mgvillafane/Calhacks-13.0-Smart-Helmet/esp32-connections.png

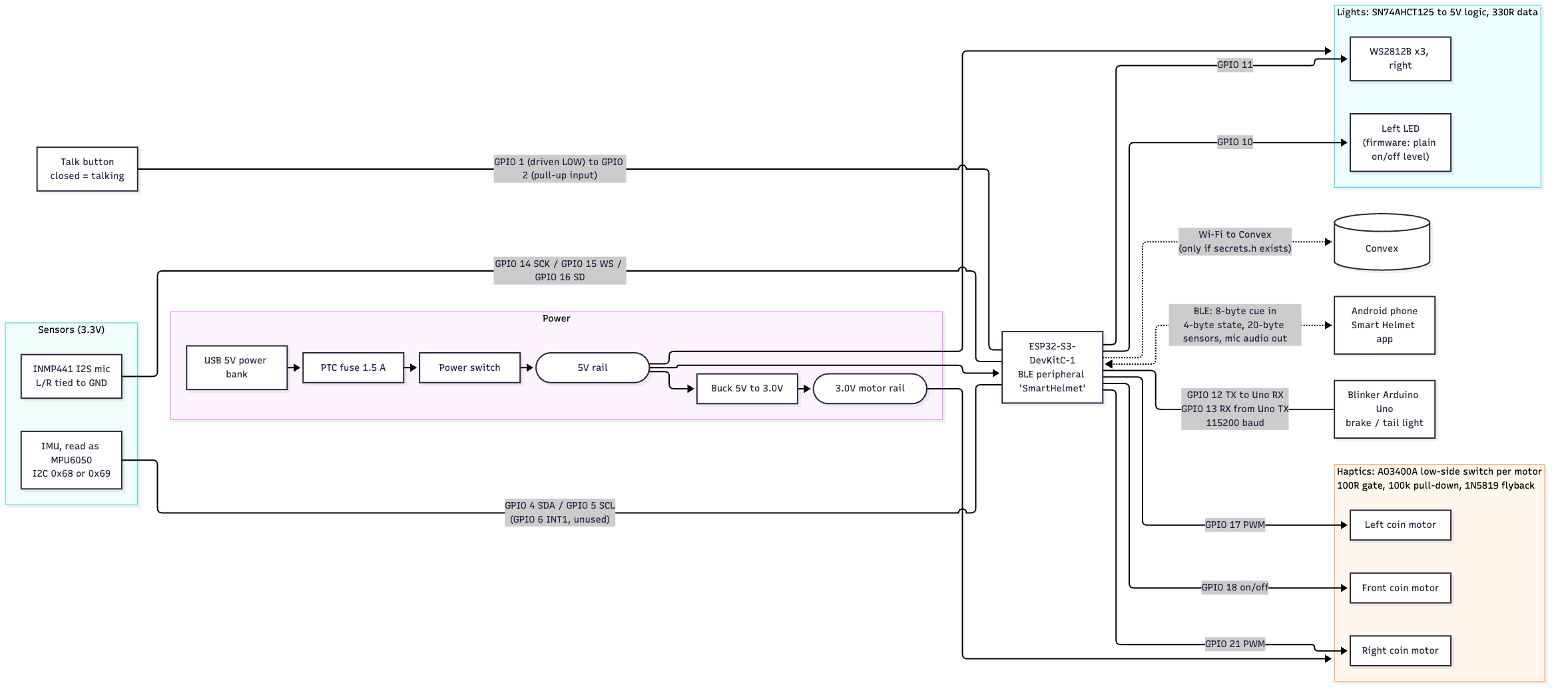
esp32-connections.png
