mgvillafane/Calhacks-13.0-Smart-Helmet/mobile/assets/go/f12.png

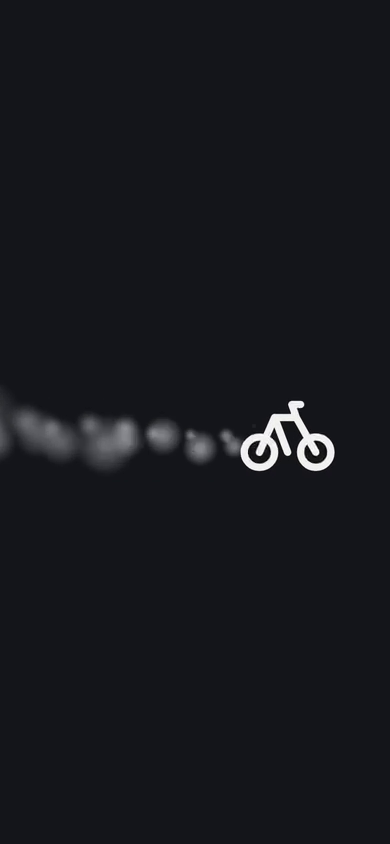
mobile/assets/go/f12.png
