mgvillafane/Calhacks-13.0-Smart-Helmet/mobile/assets/go/f14.png

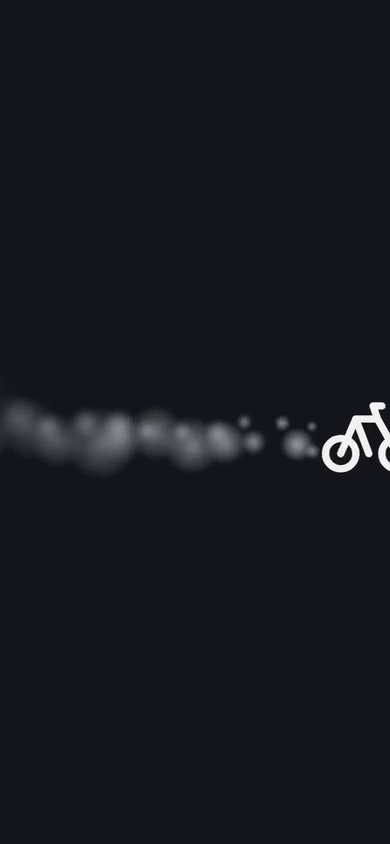
mobile/assets/go/f14.png
