mgvillafane/Calhacks-13.0-Smart-Helmet/mobile/assets/helmet-dark.png

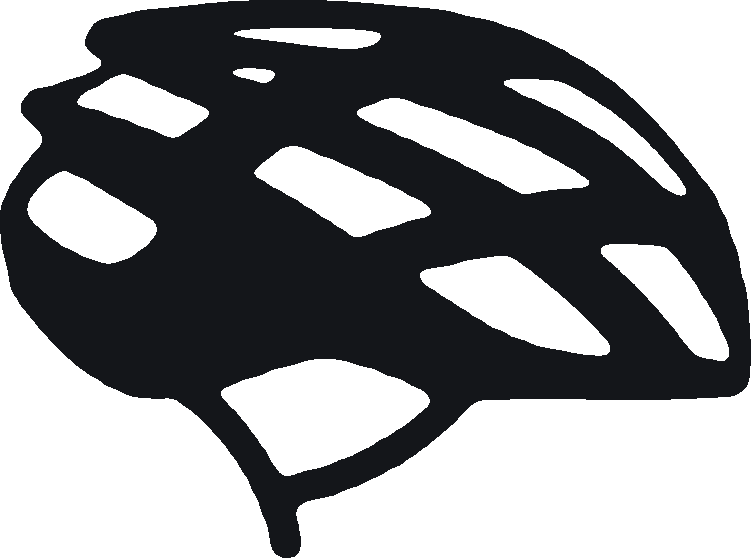
mobile/assets/helmet-dark.png
