mgvillafane/Calhacks-13.0-Smart-Helmet/mobile/assets/helmet-light.png

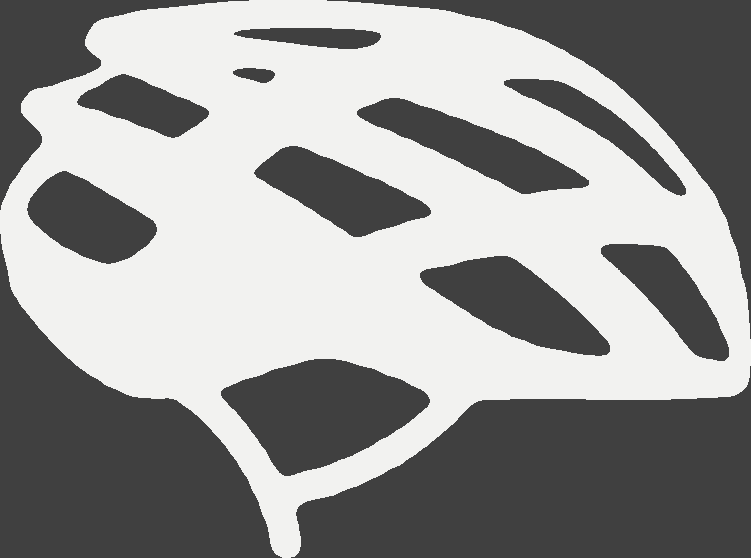
mobile/assets/helmet-light.png
