mgvillafane/Calhacks-13.0-Smart-Helmet/mobile/assets/vehicle-bicycle.png

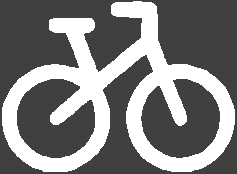
mobile/assets/vehicle-bicycle.png
