mgvillafane/Calhacks-13.0-Smart-Helmet/mobile/assets/vehicle-scooter.png

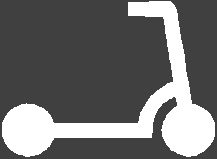
mobile/assets/vehicle-scooter.png
