mgvillafane/Calhacks-13.0-Smart-Helmet/Kicad/Helmet_Navigation.kicad_sch

## KiCad design Kicad/Helmet_Navigation.kicad_sch (2026-10-23)

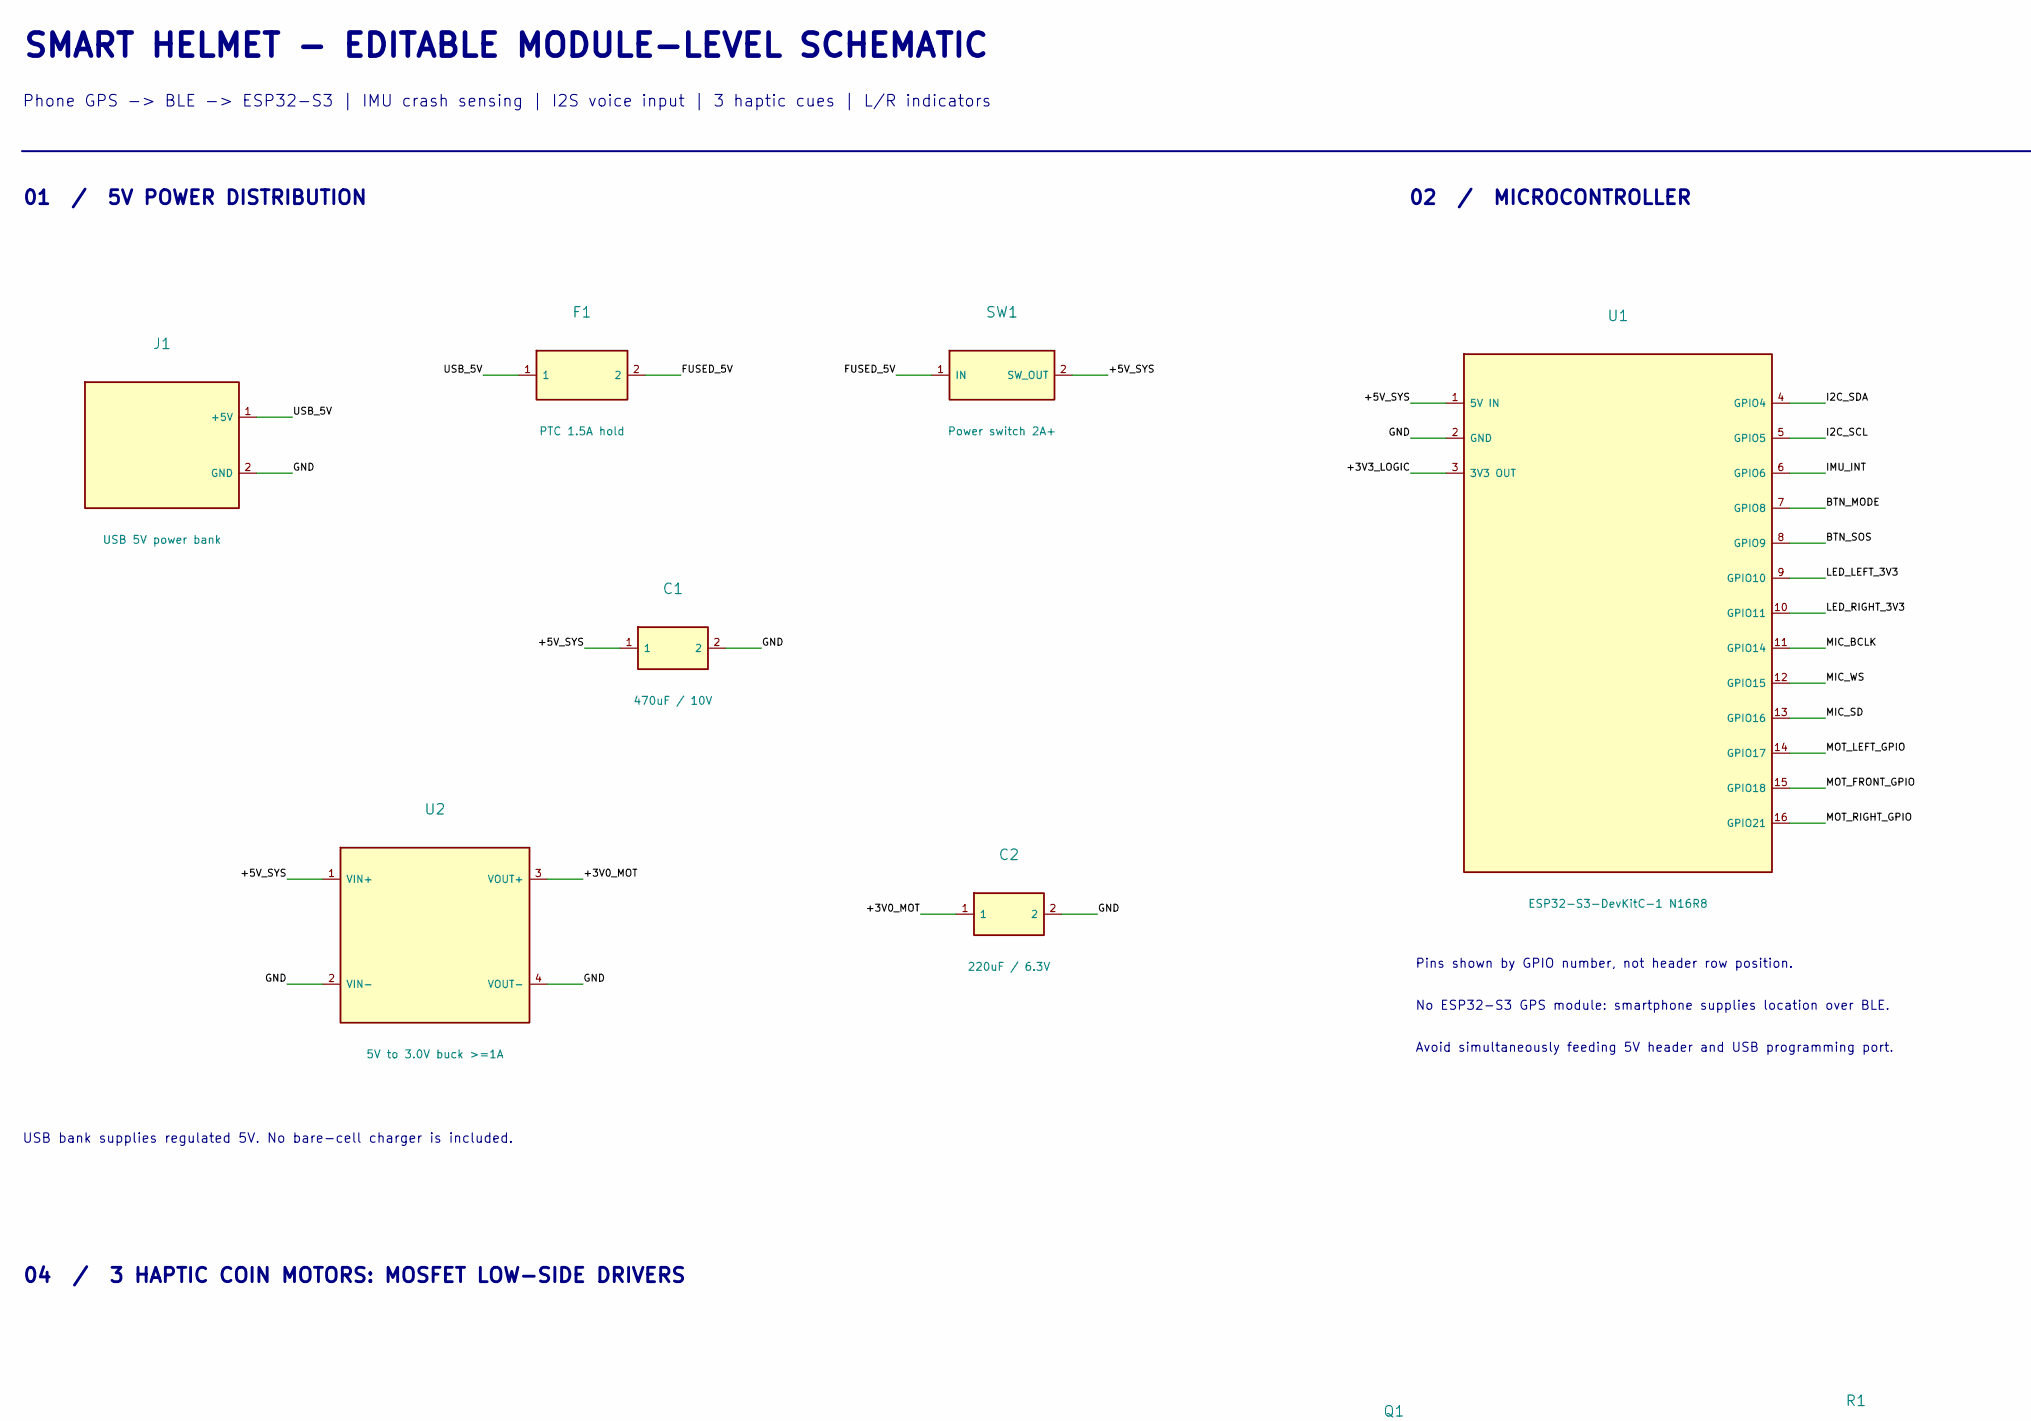
[picture p17: schematic Helmet_Navigation.kicad_sch, part in row 1, column 1]

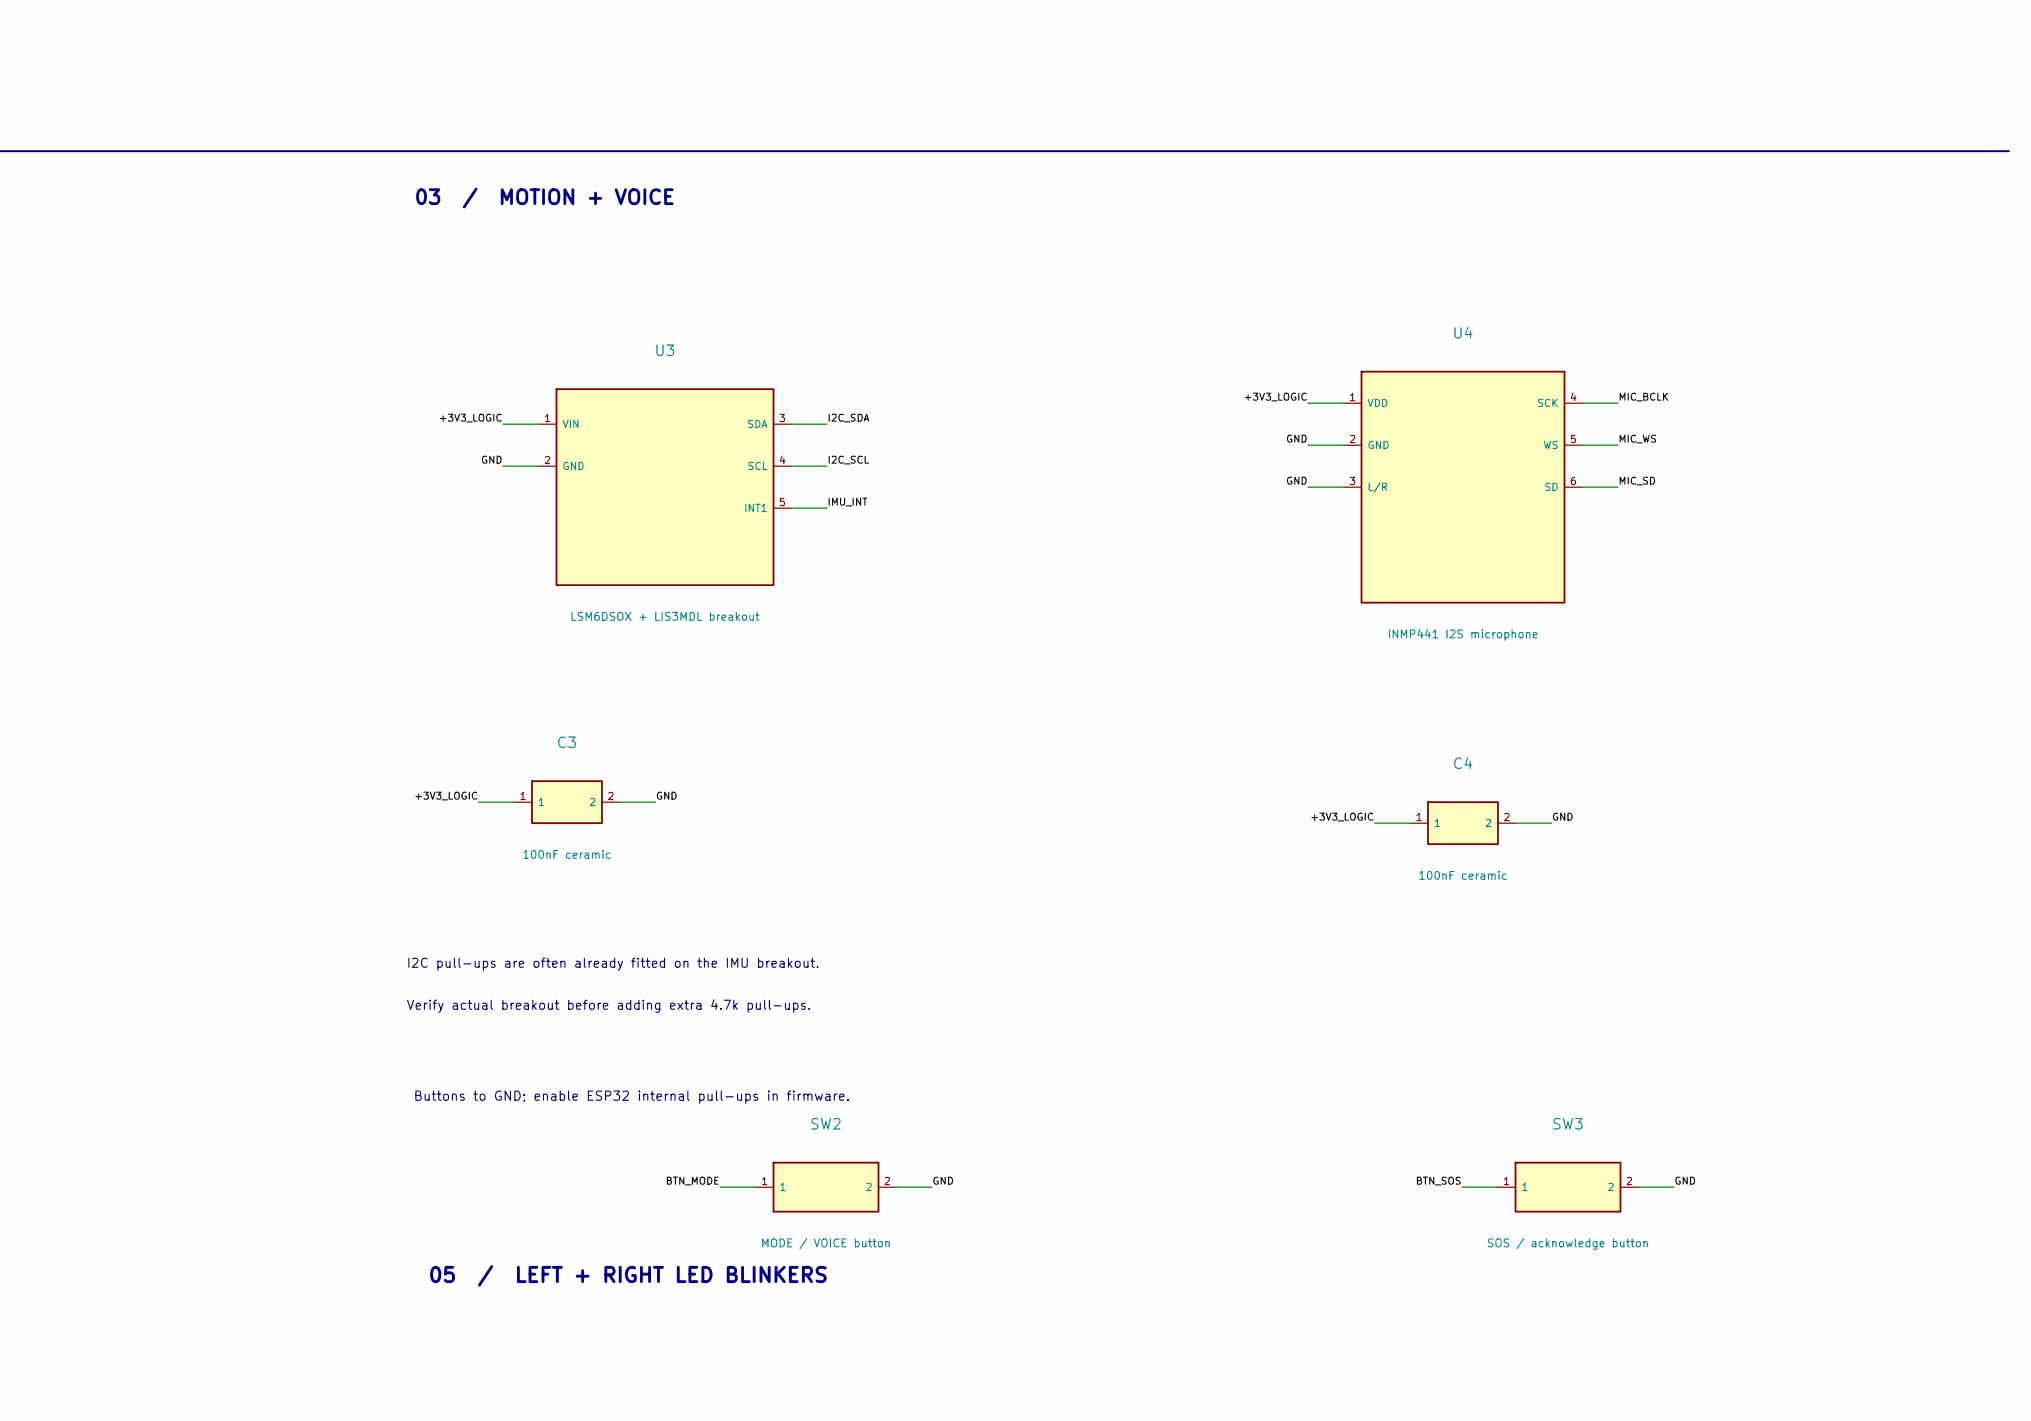
[picture p18: schematic Helmet_Navigation.kicad_sch, part in row 1, column 2]

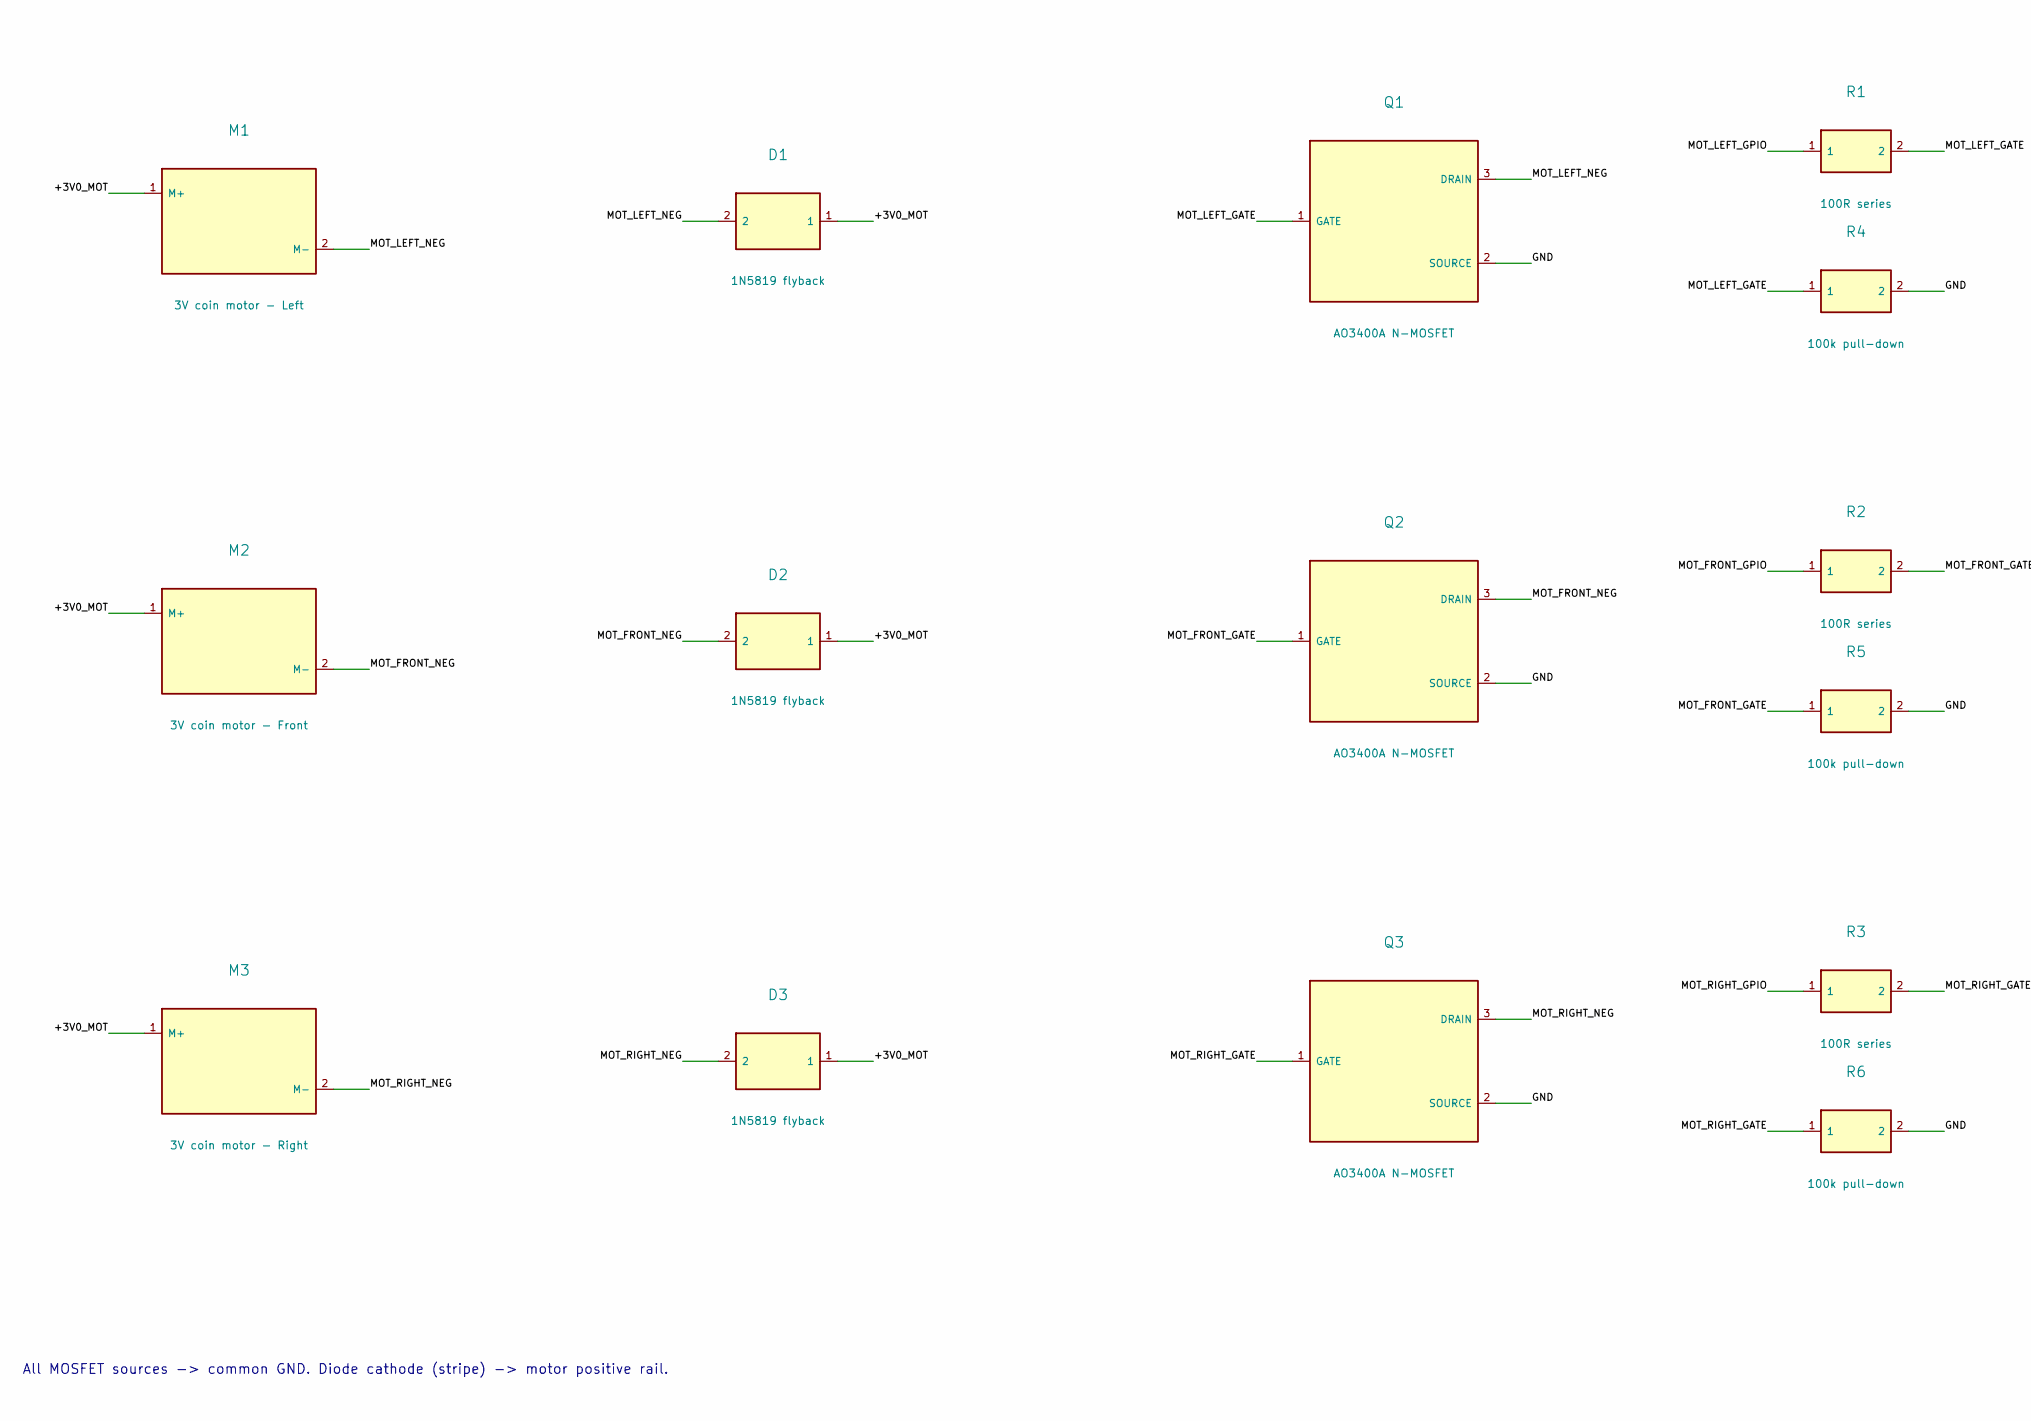
[picture p19: schematic Helmet_Navigation.kicad_sch, part in row 2, column 1]

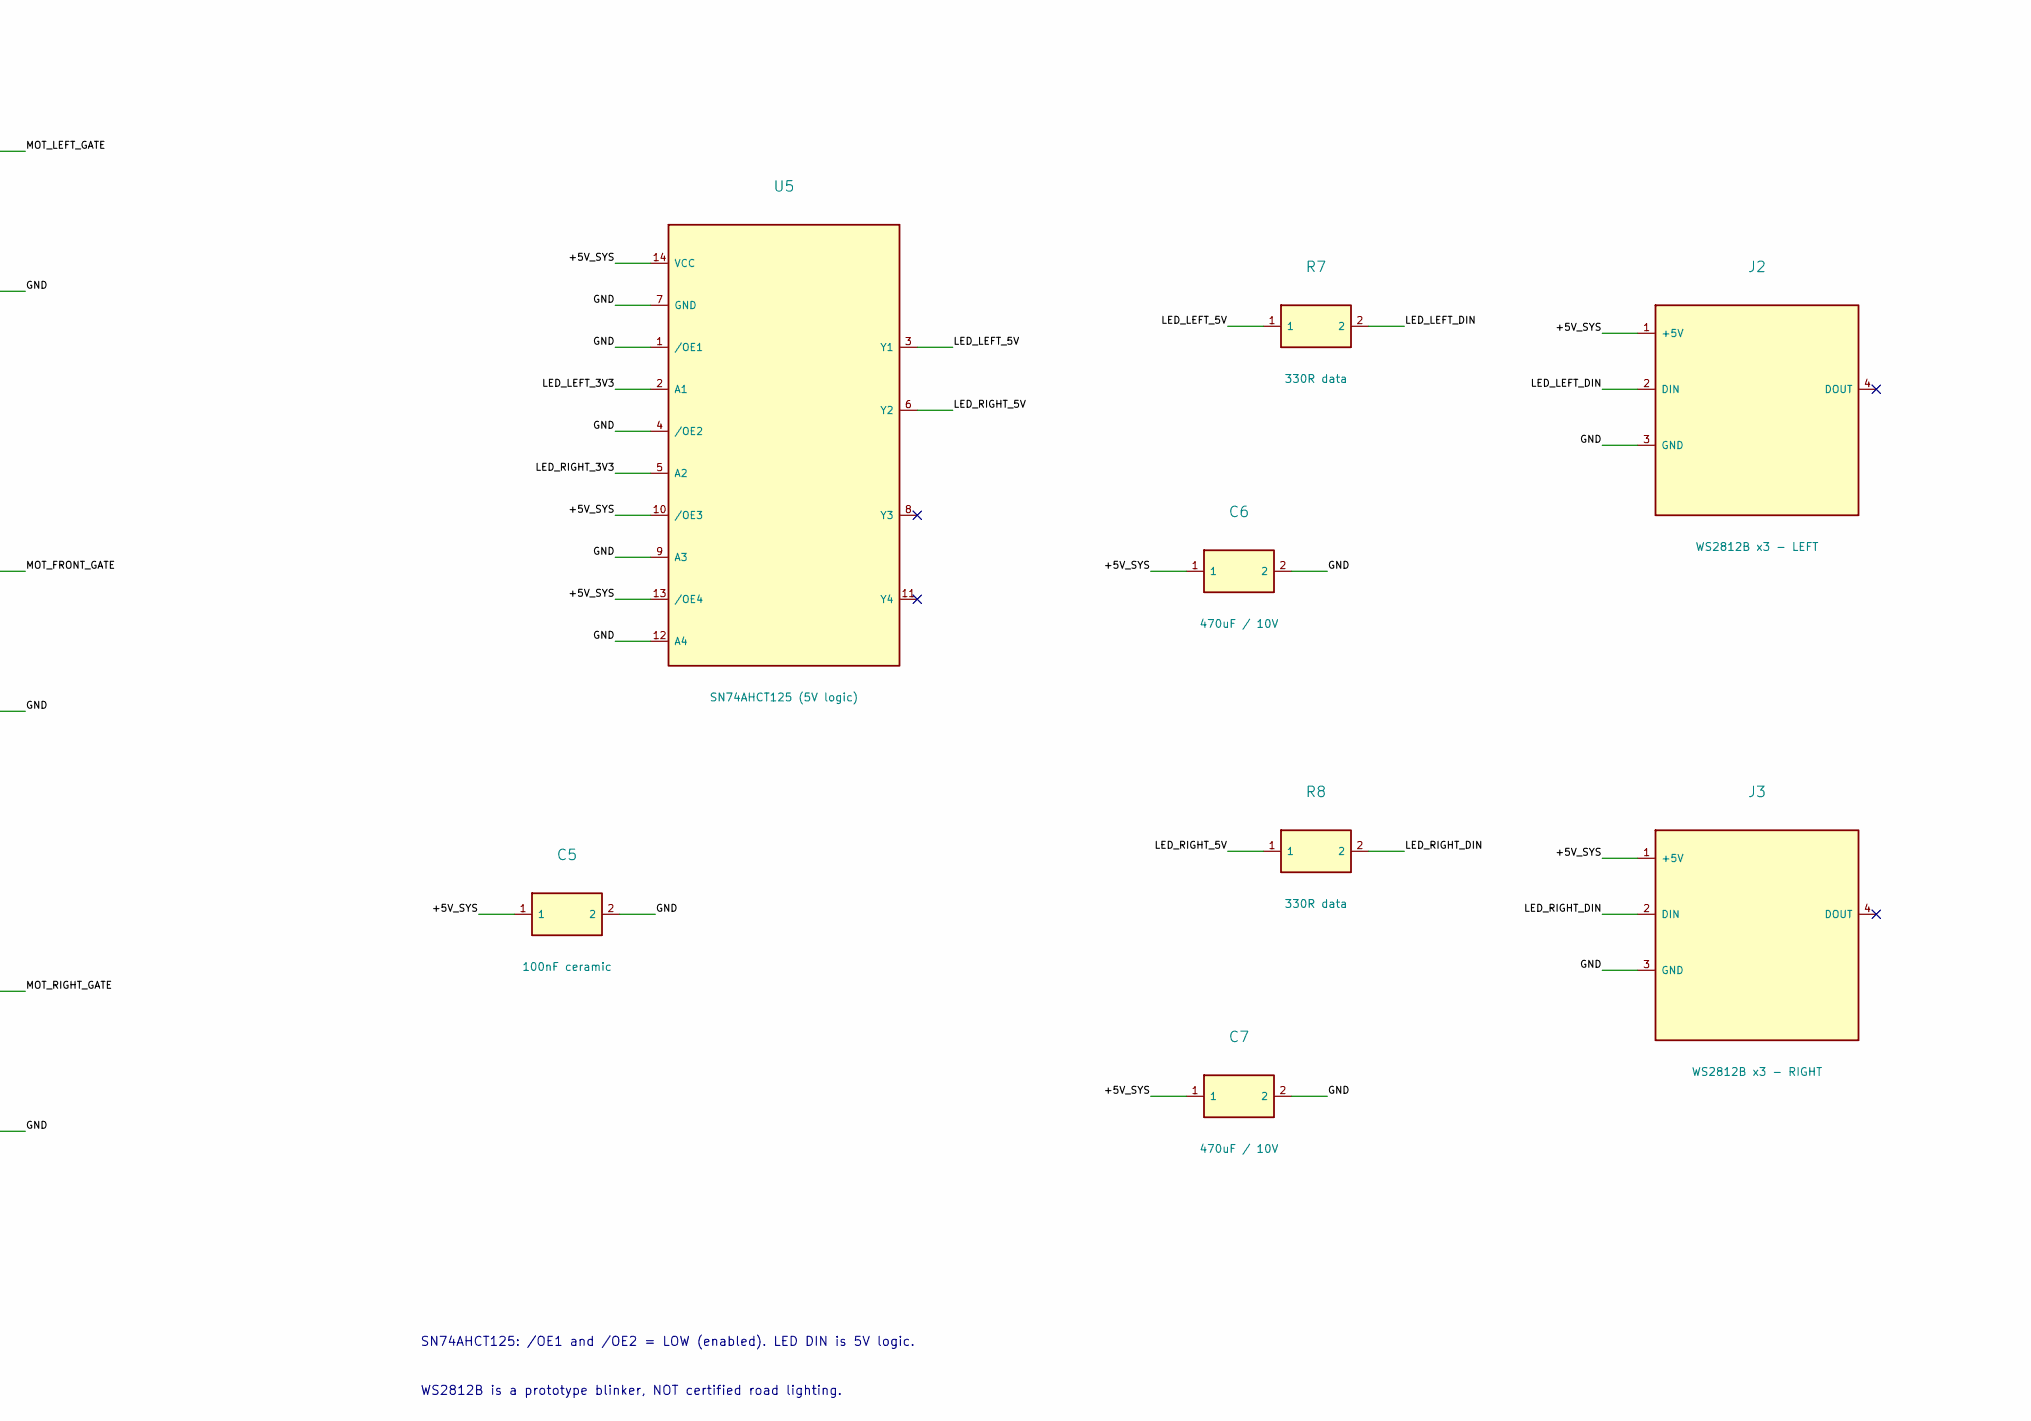
[picture p20: schematic Helmet_Navigation.kicad_sch, part in row 2, column 2]

Parts:
C1, C6, C7: 470uF / 10V
C2: 220uF / 6.3V
C3, C4, C5: 100nF ceramic
D1, D2, D3: 1N5819 flyback
F1: PTC 1.5A hold
J1: USB 5V power bank
J2: WS2812B x3 - LEFT
J3: WS2812B x3 - RIGHT
M1: 3V coin motor - Left
M2: 3V coin motor - Front
M3: 3V coin motor - Right
Q1, Q2, Q3: AO3400A N-MOSFET
R1, R2, R3: 100R series
R4, R5, R6: 100k pull-down
R7, R8: 330R data
SW1: Power switch 2A+
SW2: MODE / VOICE button
SW3: SOS / acknowledge button
U1: ESP32-S3-DevKitC-1 N16R8
U2: 5V to 3.0V buck >=1A
U3: LSM6DSOX + LIS3MDL breakout
U4: INMP441 I2S microphone
U5: SN74AHCT125 (5V logic)

Connections:
+3V0_MOT: C2.1, D1.1, D2.1, D3.1, M1.1 (M+), M2.1 (M+), M3.1 (M+), U2.3 (VOUT+)
+3V3_LOGIC: C3.1, C4.1, U1.3 (3V3 OUT), U3.1 (VIN), U4.1 (VDD)
+5V_SYS: C1.1, C5.1, C6.1, C7.1, J2.1 (+5V), J3.1 (+5V), SW1.2 (SW_OUT), U1.1 (5V IN), U2.1 (VIN+), U5.10 (/OE3), U5.13 (/OE4), U5.14 (VCC)
BTN_MODE: SW2.1, U1.7 (GPIO8)
BTN_SOS: SW3.1, U1.8 (GPIO9)
FUSED_5V: F1.2, SW1.1 (IN)
GND: C1.2, C2.2, C3.2, C4.2, C5.2, C6.2, C7.2, J1.2 (GND), J2.3 (GND), J3.3 (GND), Q1.2 (SOURCE), Q2.2 (SOURCE), Q3.2 (SOURCE), R4.2, R5.2, R6.2, SW2.2, SW3.2, U1.2 (GND), U2.2 (VIN-), U2.4 (VOUT-), U3.2 (GND), U4.2 (GND), U4.3 (L/R), U5.1 (/OE1), U5.4 (/OE2), U5.7 (GND), U5.9 (A3), U5.12 (A4)
I2C_SCL: U1.5 (GPIO5), U3.4 (SCL)
I2C_SDA: U1.4 (GPIO4), U3.3 (SDA)
IMU_INT: U1.6 (GPIO6), U3.5 (INT1)
LED_LEFT_3V3: U1.9 (GPIO10), U5.2 (A1)
LED_LEFT_5V: R7.1, U5.3 (Y1)
LED_LEFT_DIN: J2.2 (DIN), R7.2
LED_RIGHT_3V3: U1.10 (GPIO11), U5.5 (A2)
LED_RIGHT_5V: R8.1, U5.6 (Y2)
LED_RIGHT_DIN: J3.2 (DIN), R8.2
MIC_BCLK: U1.11 (GPIO14), U4.4 (SCK)
MIC_SD: U1.13 (GPIO16), U4.6 (SD)
MIC_WS: U1.12 (GPIO15), U4.5 (WS)
MOT_FRONT_GATE: Q2.1 (GATE), R2.2, R5.1
MOT_FRONT_GPIO: R2.1, U1.15 (GPIO18)
MOT_FRONT_NEG: D2.2, M2.2 (M-), Q2.3 (DRAIN)
MOT_LEFT_GATE: Q1.1 (GATE), R1.2, R4.1
MOT_LEFT_GPIO: R1.1, U1.14 (GPIO17)
MOT_LEFT_NEG: D1.2, M1.2 (M-), Q1.3 (DRAIN)
MOT_RIGHT_GATE: Q3.1 (GATE), R3.2, R6.1
MOT_RIGHT_GPIO: R3.1, U1.16 (GPIO21)
MOT_RIGHT_NEG: D3.2, M3.2 (M-), Q3.3 (DRAIN)
USB_5V: F1.1, J1.1 (+5V)

Notes on the sheet:
SMART HELMET - EDITABLE MODULE-LEVEL SCHEMATIC
Phone GPS -> BLE -> ESP32-S3 | IMU crash sensing | I2S voice input | 3 haptic cues | L/R indicators
01 / 5V POWER DISTRIBUTION
USB bank supplies regulated 5V. No bare-cell charger is included.
02 / MICROCONTROLLER
Pins shown by GPIO number, not header row position.
No ESP32-S3 GPS module: smartphone supplies location over BLE.
Avoid simultaneously feeding 5V header and USB programming port.
03 / MOTION + VOICE
I2C pull-ups are often already fitted on the IMU breakout.
Verify actual breakout before adding extra 4.7k pull-ups.
04 / 3 HAPTIC COIN MOTORS: MOSFET LOW-SIDE DRIVERS
All MOSFET sources -> common GND. Diode cathode (stripe) -> motor positive rail.
05 / LEFT + RIGHT LED BLINKERS
SN74AHCT125: /OE1 and /OE2 = LOW (enabled). LED DIN is 5V logic.
WS2812B is a prototype blinker, NOT certified road lighting.
Buttons to GND; enable ESP32 internal pull-ups in firmware.
