mgvillafane/Calhacks-13.0-Smart-Helmet/firmware/src/mic.c

#include "mic.h"

#include <stddef.h>

bool talk_streaming(bool closed) {
    return closed;
}

int32_t mic_louder_slot(int32_t left, int32_t right) {
    uint32_t left_abs = left < 0 ? (uint32_t)0 - (uint32_t)left : (uint32_t)left;
    uint32_t right_abs = right < 0 ? (uint32_t)0 - (uint32_t)right : (uint32_t)right;
    return right_abs > left_abs ? right : left;
}

int16_t mic_pcm16(MicFilter *filter, int32_t slot) {
    int32_t in = slot >> 8;
    int32_t out;
    if (filter == NULL) {
        return 0;
    }
    if (!filter->started) {
        filter->last_in = in;
        filter->last_out = 0;
        filter->started = true;
    }
    out = in - filter->last_in + (int32_t)(((int64_t)filter->last_out * 255) / 256);
    filter->last_in = in;
    filter->last_out = out;
    out >>= MIC_SHIFT;
    if (out > 32767) {
        return 32767;
    }
    if (out < -32768) {
        return -32768;
    }
    return (int16_t)out;
}
