mgvillafane/Calhacks-13.0-Smart-Helmet/firmware/test_blinker_arduino/test_blinker_arduino.ino

#include <Adafruit_NeoPixel.h>

// ESP32 GPIO 12 TX -> Arduino RX (pin 0)
// ESP32 GPIO 13 RX -> Arduino TX (pin 1)
// Share ground. Letters at 115200: L left, R right, U u-turn, O turn off.
// B holds the brake strip solid red and b releases it. A turn can stay lit while braking.
// When not braking, the brake strip flashes red once every 2 seconds as a tail light.
// Any letter older than the timeout turns the turn strips off and releases the brake.
// At power-up the strips flash left, right, then brake once.
// The on-board LED (pin 13) stays lit while letters keep arriving.
// Every received byte is echoed on TX so a laptop on USB can watch the link.

#define LEFT_PIN  6
#define RIGHT_PIN 7
#define BRAKE_PIN 8

#define NUM_LEDS 5  // LEDs per strip
#define BLINK_MS 400
#define COMMAND_TIMEOUT_MS 600
#define TAIL_PERIOD_MS 2000
#define TAIL_FLASH_MS 250

Adafruit_NeoPixel leftStrip(NUM_LEDS, LEFT_PIN, NEO_GRB + NEO_KHZ800);
Adafruit_NeoPixel rightStrip(NUM_LEDS, RIGHT_PIN, NEO_GRB + NEO_KHZ800);
Adafruit_NeoPixel brakeStrip(NUM_LEDS, BRAKE_PIN, NEO_GRB + NEO_KHZ800);

char turn = 'O';
bool brakeOn = false;
unsigned long commandMs = 0;
bool blinkOn = true;
unsigned long blinkMs = 0;

void setColor(Adafruit_NeoPixel &strip, int r, int g, int b) {
  for (int i = 0; i < NUM_LEDS; i++) {
    strip.setPixelColor(i, strip.Color(r, g, b));
  }
  strip.show();
}

void showCommand(char active, bool on, bool brake) {
  setColor(leftStrip, 0, 0, 0);
  setColor(rightStrip, 0, 0, 0);
  setColor(brakeStrip, 0, 0, 0);
  if (active == 'L' && on) {
    setColor(leftStrip, 255, 150, 0);
  } else if (active == 'R' && on) {
    setColor(rightStrip, 255, 150, 0);
  } else if (active == 'U') {
    if (on) {
      setColor(leftStrip, 255, 150, 0);
    } else {
      setColor(rightStrip, 255, 150, 0);
    }
  }
  if (brake) {
    setColor(brakeStrip, 255, 0, 0);
  }
}

void setup() {
  Serial.begin(115200);

  leftStrip.begin();
  rightStrip.begin();
  brakeStrip.begin();

  leftStrip.setBrightness(80);
  rightStrip.setBrightness(80);
  brakeStrip.setBrightness(80);

  pinMode(LED_BUILTIN, OUTPUT);
  digitalWrite(LED_BUILTIN, LOW);

  showCommand('L', true, false);
  delay(400);
  showCommand('R', true, false);
  delay(400);
  showCommand('O', false, true);
  delay(400);
  showCommand('O', false, false);
  while (Serial.available() > 0) {
    Serial.read();
  }
}

void loop() {
  while (Serial.available() > 0) {
    char next = (char)Serial.read();
    Serial.write(next);
    if (next == '\n' || next == '\r') {
      continue;
    }
    if (next == 'L' || next == 'R' || next == 'U' || next == 'O') {
      if (next != turn) {
        blinkOn = true;
        blinkMs = millis();
      }
      turn = next;
      commandMs = millis();
    } else if (next == 'B' || next == 'b') {
      brakeOn = next == 'B';
      commandMs = millis();
    }
  }

  bool linked = commandMs != 0 && millis() - commandMs <= COMMAND_TIMEOUT_MS;
  digitalWrite(LED_BUILTIN, linked ? HIGH : LOW);
  if (!linked) {
    turn = 'O';
    brakeOn = false;
  }

  bool on = true;
  if (turn == 'L' || turn == 'U' || turn == 'R') {
    if (millis() - blinkMs >= BLINK_MS) {
      blinkOn = !blinkOn;
      blinkMs = millis();
    }
    on = blinkOn;
  }

  bool brakeLit = brakeOn || millis() % TAIL_PERIOD_MS < TAIL_FLASH_MS;

  static char shown = 0;
  static bool shownOn = false;
  static bool shownBrake = false;
  if (turn != shown || on != shownOn || brakeLit != shownBrake) {
    showCommand(turn, on, brakeLit);
    shown = turn;
    shownOn = on;
    shownBrake = brakeLit;
  }
}
