mgvillafane/Calhacks-13.0-Smart-Helmet/firmware/include/secrets.example.h

#pragma once

/* Copy to secrets.h (gitignored) to send helmet health to Convex over Wi-Fi.
 * A phone hotspot works on a ride. Use the .convex.cloud URL, not .convex.site.
 */

#define HELMET_WIFI_SSID "your-hotspot"
#define HELMET_WIFI_PASS "your-password"
#define HELMET_CONVEX_URL "https://your-deployment.convex.cloud"
