mgvillafane/Calhacks-13.0-Smart-Helmet/(commit log)

2026-10-23 Initial commit - idea
    [Helmet_Navigation.kicad_sch]
2026-10-24 Save the navigation app plan before implementation.
    Record the phone routing, helmet cue, deploy, and prize-track design so the team can build from it later.
2026-10-24 Find the helmet when Android Bluetooth settings can already see it.
    Nearby devices is enough on Android 12, and an unfiltered scan matches the name that a service-UUID filter was dropping.
2026-10-24 Drive GPIO 10 as a slow level while a left turn is active.
    The NeoPixel bitstream on that pin is too fast to confirm on the bench, so the left strip stays commented out until the wire is verified.
    [main.cpp]
2026-10-24 Stream MPU6050 samples and add a live plot.
    The helmet prints accel and gyro over serial so the trace can be watched while the board is connected.
2026-10-24 Show the wireframe screens and roll a bike or scooter after GO.
2026-10-24 Read the INMP441 microphone and print samples.
2026-10-24 LED lights
2026-10-24 Match the phone screens to the dark wireframe.
2026-10-24 Send turn and brake letters from the helmet to the blinker.
2026-10-24 Add front button to debug screen
2026-10-24 Keep blinker letters flowing when nobody reads the helmet USB
    A blocking USB print stalled the loop for seconds, so the Uno timed out
    and the strips stayed dark. The Uno sketch now flashes each strip at
    power-up, lights its on-board LED while letters arrive, echoes received
    bytes on USB, and alternates the strips for a u-turn.
    [main.cpp, test_blinker_arduino.ino]
2026-10-25 Log rides, helmet links, and helmet health to Convex
    The phone records ride starts and ends, each cue change the engine makes,
    reroutes, arrival, and Bluetooth connect results. No coordinates or place
    names are stored. The helmet reports boot reset reasons, minute health,
    stale cue stops, and brakes over Wi-Fi when firmware/include/secrets.h
    exists; without it the firmware runs on BLE alone.
    [main.cpp, secrets.example.h, telemetry.cpp, telemetry.h]
2026-10-25 Flash the brake strip as a tail light and hold it red while braking
2026-10-25 Stream the helmet mic to Grok Voice while the GPIO 7 talk switch is closed
2026-10-25 helmet button in debut screen
2026-10-25 hold instead of button taps
2026-10-25 Try to fix button debut
    [main.cpp]
2026-10-25 app button try fix
2026-10-25 fix button please
2026-10-25 imu fix
2026-10-26 Add the ESP32 helmet wiring diagram
